techcakelab/DIY-Auto-Developing-Tank-Roller-UnderWater-2/3Dmodels/Main body - qty 1.STL

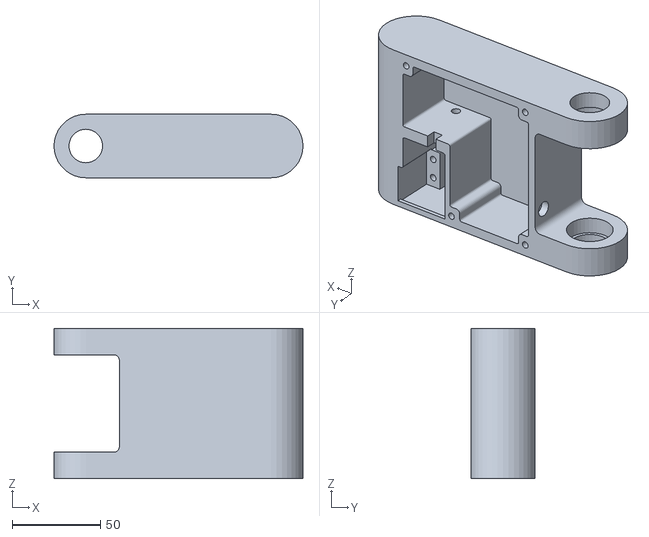
[picture p2: CAD file, 2026-10-23]
3Dmodels/Main body - qty 1.STL
141.0 x 36.0 x 85.0
