techcakelab/DIY-Auto-Developing-Tank-Roller-UnderWater-2/3Dmodels/Overall.FCStd

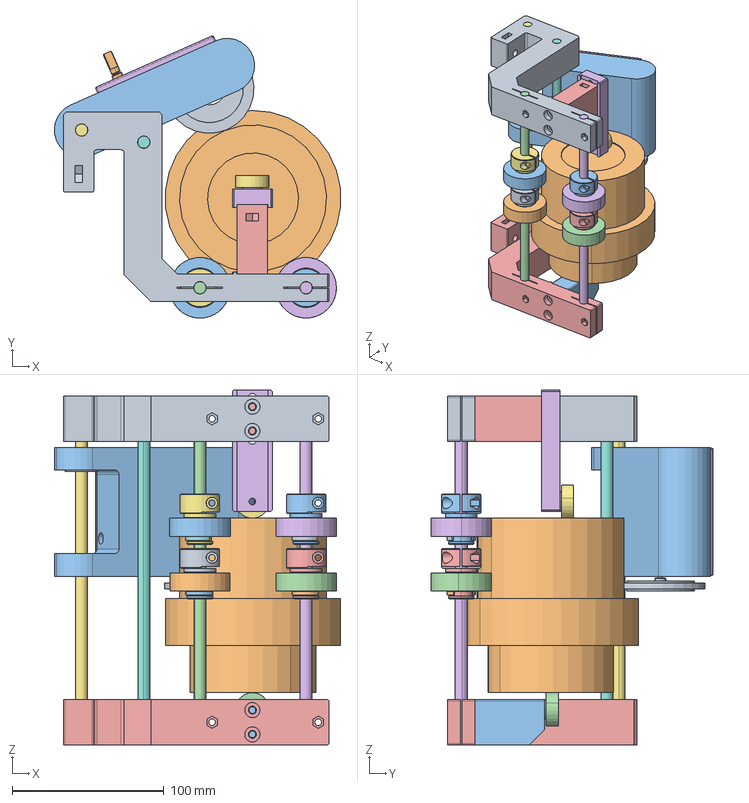
[picture p3: CAD file, 2026-10-23]
3Dmodels/Overall.FCStd
188.7 x 186.0 x 234.0 mm
Structure - qty 2
Tank
B608
OD 8 shaft
Structure - qty 001
OD 8 shaft001
Roller Adjust - qty 4
C shape - qty 4
Roller Adjust - qty 001
B609
Roller Adjust - qty 002
B610
Roller Adjust - qty 003
B611
OD 8 shaft002
OD 8 shaft003
B6001
DC Gear Motor N20 12GA
Main body - qty 1
DRV8833_A
ESP32-C3 supermini v5
Cover - qty 1
B6002
Roda 34 mm_Valor predeterminado
KY-040 Rotary Encoder
Side roller - qty 1
B6003
Spacer 1 - qty 1
Bearing holder - qty 1
B6004
Display TM1637_\X2\041f043e\X0\ \X2\0443043c043e043b04470430043d0438044e\X0\
C shape - qty 001
C shape - qty 002
C shape - qty 003
