techcakelab/DIY-Auto-Developing-Tank-Roller-UnderWater-2/3Dmodels/Structure - qty 2.STL

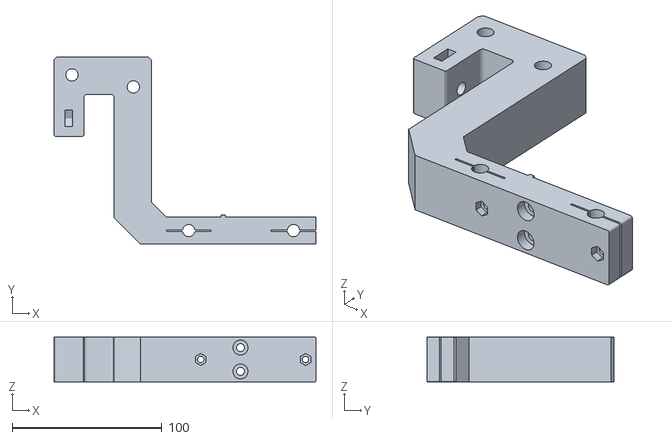
[picture p4: CAD file, 2026-10-23]
3Dmodels/Structure - qty 2.STL
175.0 x 125.0 x 30.0
