techcakelab/DIY-Auto-Developing-Tank-Roller-UnderWater-2/3Dmodels/Spacer 1 - qty 1.STL

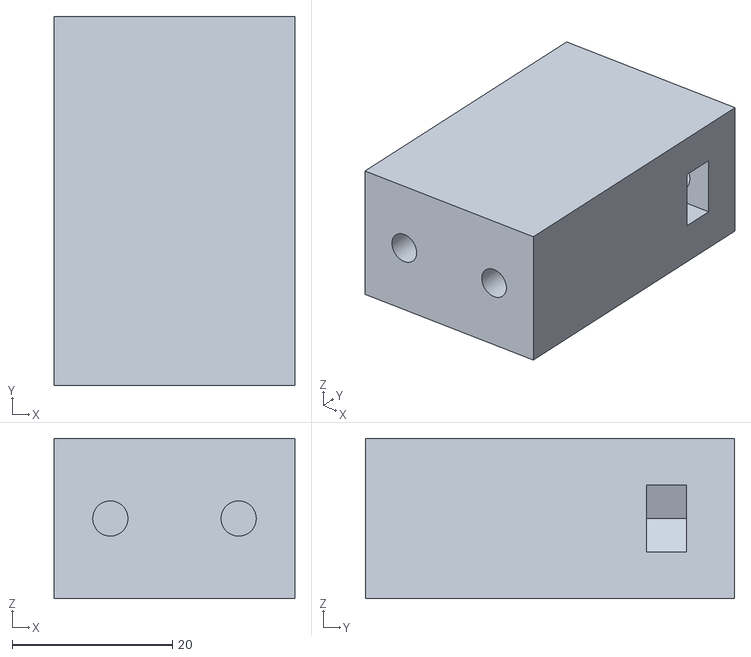
[picture p5: CAD file, 2026-10-23]
3Dmodels/Spacer 1 - qty 1.STL
30.0 x 46.0 x 20.0
