techcakelab/DIY-Auto-Developing-Tank-Roller-UnderWater-2/3Dmodels/Roller Adjust - qty 4.STL

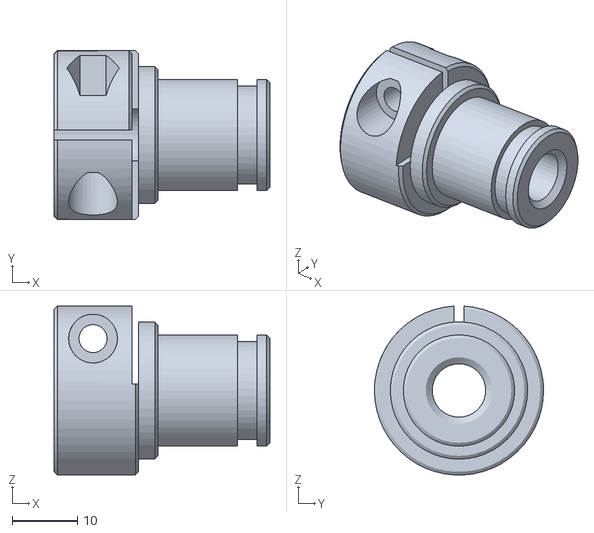
[picture p6: CAD file, 2026-10-23]
3Dmodels/Roller Adjust - qty 4.STL
33.2 x 26.0 x 26.0
