techcakelab/DIY-Auto-Developing-Tank-Roller-UnderWater-2/3Dmodels/Side roller - qty 1.STL

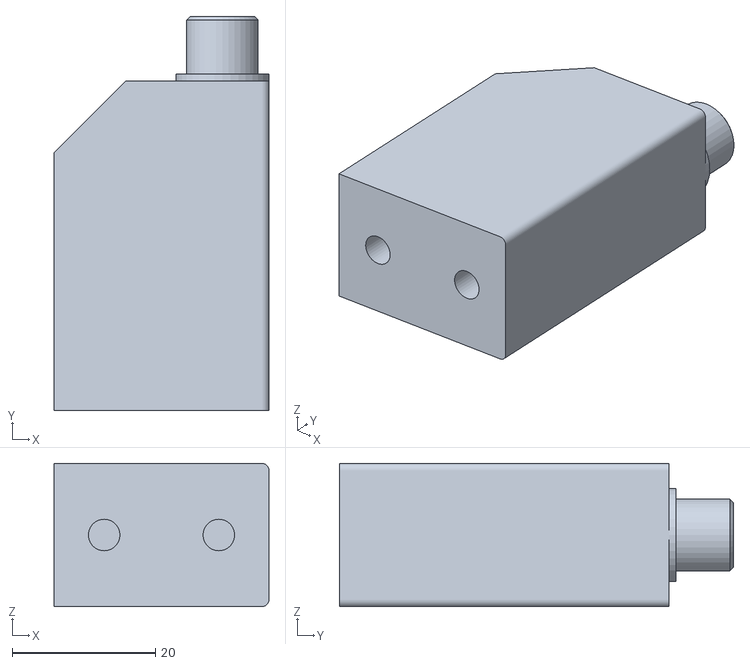
[picture p7: CAD file, 2026-10-23]
3Dmodels/Side roller - qty 1.STL
30.0 x 55.0 x 20.0
