techcakelab/DIY-Auto-Developing-Tank-Roller-UnderWater-2/3Dmodels/C shape - qty 4.STL

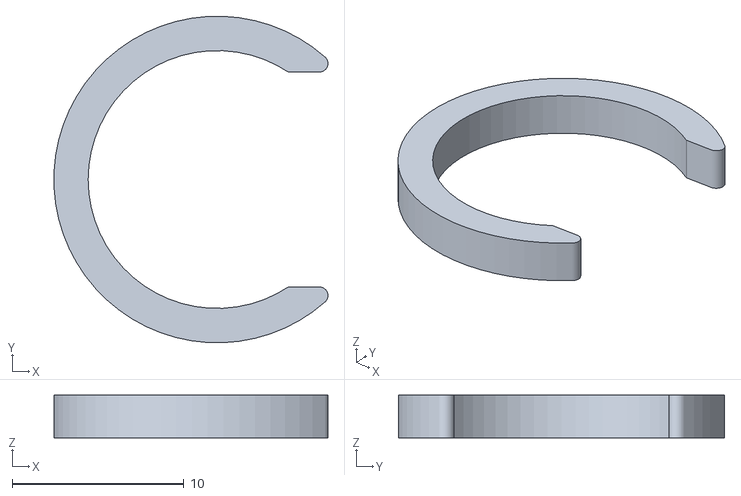
[picture p8: CAD file, 2026-10-23]
3Dmodels/C shape - qty 4.STL
15.9 x 19.0 x 2.50
