techcakelab/DIY-Auto-Developing-Tank-Roller-UnderWater-2/3Dmodels/Bearing holder - qty 1.STL

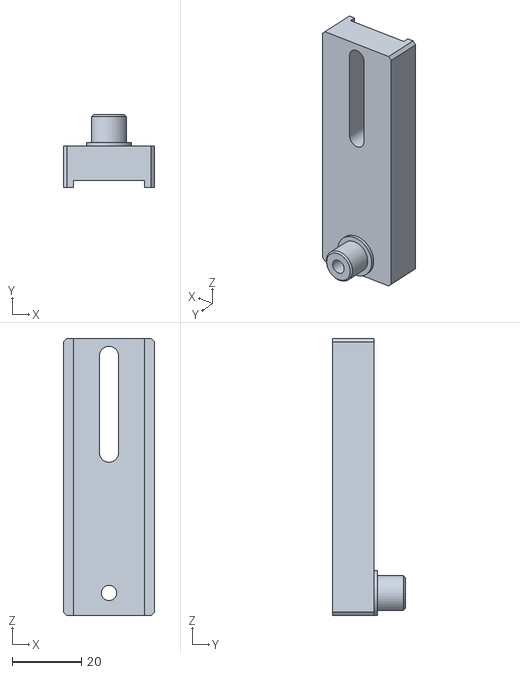
[picture p9: CAD file, 2026-10-23]
3Dmodels/Bearing holder - qty 1.STL
26.4 x 21.0 x 80.0
