techcakelab/DIY-Auto-Developing-Tank-Roller-UnderWater-2/3Dmodels/Cover - qty 1.STL

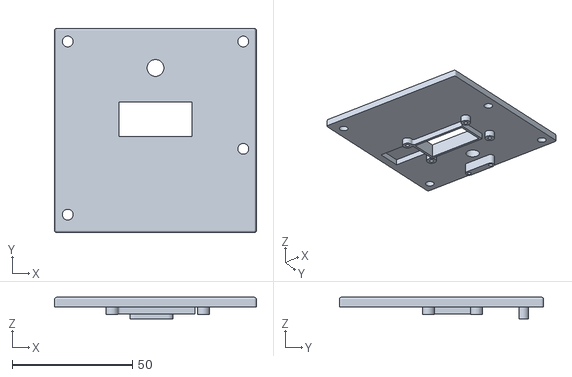
[picture p10: CAD file, 2026-10-23]
3Dmodels/Cover - qty 1.STL
84.0 x 85.0 x 9.00
