techcakelab/DIY-Auto-Developing-Tank-Roller-UnderWater-2/(notices)

Notices in the files:
README.md:
License: MIT
